K-M/oled-desktop-pet/hardware/enclosure/lid.stl

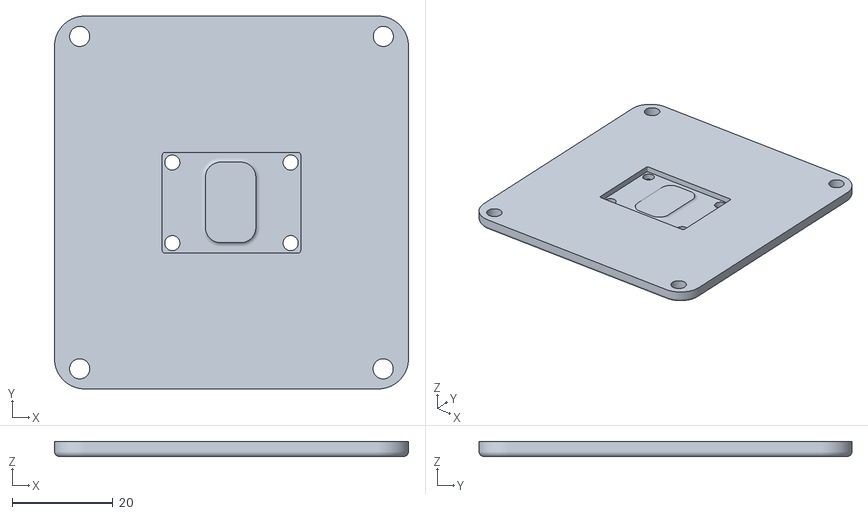
[picture p7: CAD file, 2026-10-16]
hardware/enclosure/lid.stl
70.3 x 74.0 x 3.00
