K-M/oled-desktop-pet/hardware/enclosure/body.stl

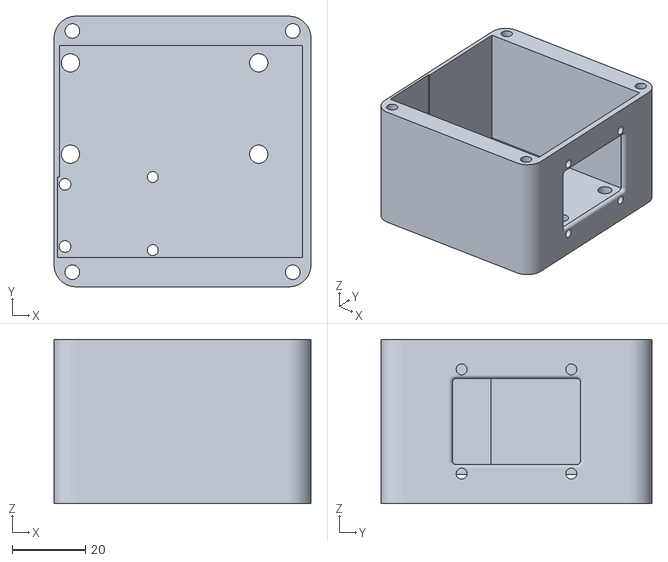
[picture p8: CAD file, 2026-10-16]
hardware/enclosure/body.stl
70.3 x 74.0 x 45.0
