K-M/oled-desktop-pet/(list of files, cad)

Other CAD files:
hardware/enclosure/desktop_pet_housing.f3d
