K-M/oled-desktop-pet/(commit log)

2026-10-16 Initial commit: OLED desktop pet firmware, tests, tools and docs
    ESP8266 NodeMCU + 1.3" SH1106 OLED desktop pet with 60 fps procedural
    eyes, a hidden capacitive touch pad, attention-driven moods, and
    delta-sigma audio with a pre-rendered SAM "pet me" clip.
    Claude-Session: https://claude.ai/code/session_018PQi8VJicf5JbhqwMGJwpt
2026-10-16 Add enclosure, schematic, photos and demo videos
    - Enclosure: body and lid STLs plus the Fusion source, with measured
    dimensions and the 1.5 mm touch wall documented.
    - Audio filter schematic (SVG + PNG) for the as-built 10 k / 1 k / 22 nF
    network and 100 uF decoupling.
    - Photos, enclosure render, and petting / mute demos as 720p MP4 (with
    sound, tone-mapped from HDR) and GIF previews for the README.
    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
    [body.stl, desktop_pet_housing.f3d, lid.stl]
2026-10-16 Document print settings, fasteners and USB-C power input
    - Enclosure: Bambu "0.20mm Standard" / Generic PLA, 20 % infill;
    M4 x 60 mm lid screws, M2.5 x 8 mm for all electronics.
    - BOM and wiring: USB-C breakout (VBUS -> 5 V rail) as the power input;
    micro-USB used only for flashing.
    - Schematic: label the 5 V rail's source.
    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
